OpenLabTools/OpenLabTools/Actuators/Linear Translation Stage Tutorial/Images/Step 12 - Bearings/12.4 Installing LM8UU.JPG

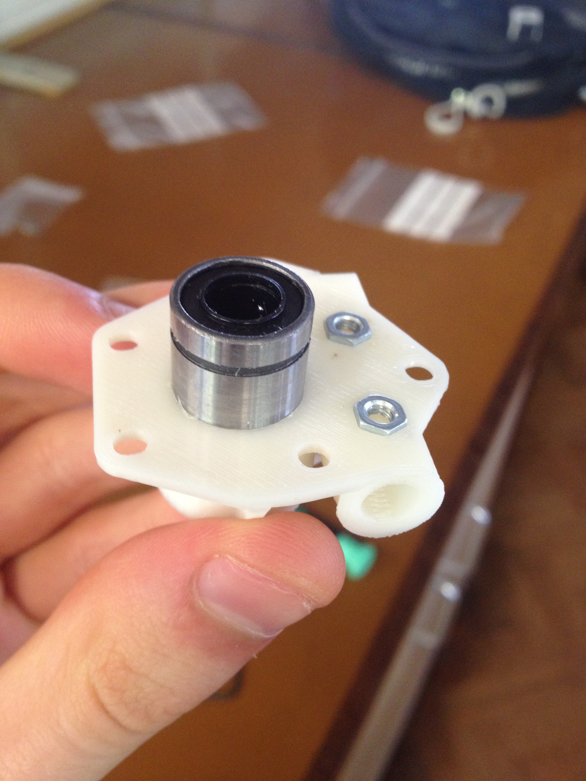
Actuators/Linear Translation Stage Tutorial/Images/Step 12 - Bearings/12.4 Installing LM8UU.JPG
