OpenLabTools/OpenLabTools/Actuators/Linear Translation Stage Tutorial/Images/Step 2 - Base/2.1.4 Stepper motor mounting plate.jpeg

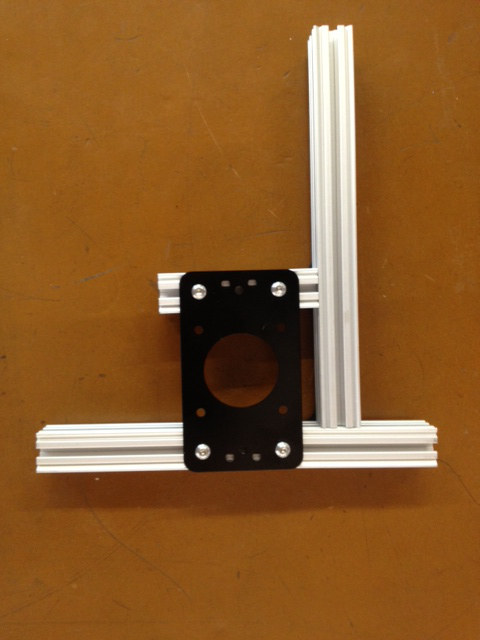
Actuators/Linear Translation Stage Tutorial/Images/Step 2 - Base/2.1.4 Stepper motor mounting plate.jpeg
