OpenLabTools/OpenLabTools/README.md

OpenLabTools
============

Main repository for the OpenLabTools project.
