OpenLabTools/OpenLabTools/Actuators/Linear Translation Stage Tutorial/Images/Step 1 - Printing the parts/Optics Clamp.JPG

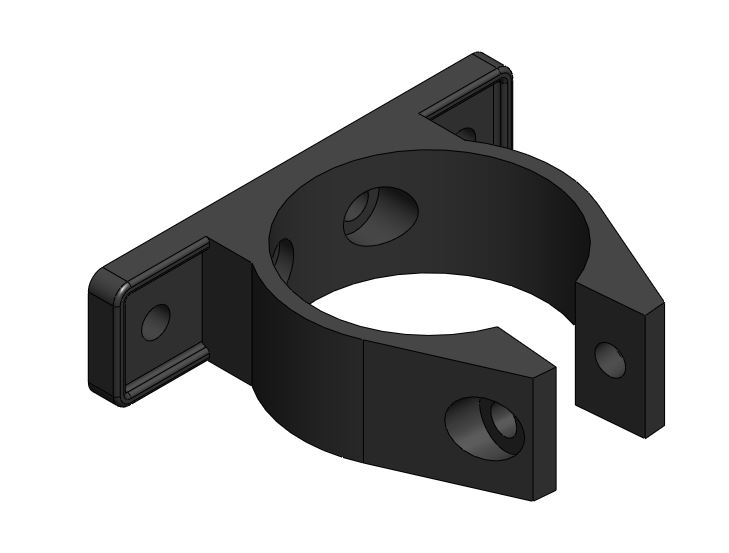
Actuators/Linear Translation Stage Tutorial/Images/Step 1 - Printing the parts/Optics Clamp.JPG
