OpenLabTools/OpenLabTools/Actuators/Linear Translation Stage Tutorial/Images/Step 7 - Optics Clamp/Optic Clamp Schematic.JPG

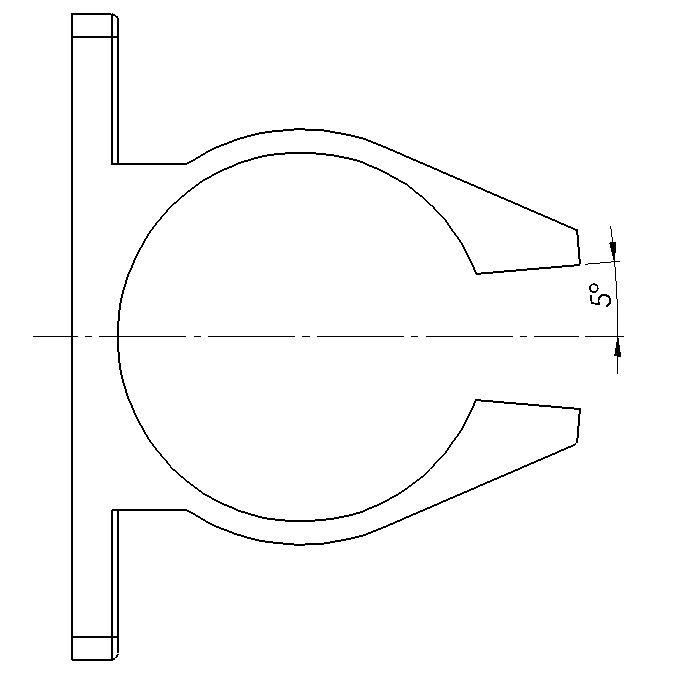
Actuators/Linear Translation Stage Tutorial/Images/Step 7 - Optics Clamp/Optic Clamp Schematic.JPG
