OpenLabTools/OpenLabTools/Actuators/Linear Translation Stage Tutorial/Images/Step 7 - Optics Clamp/Optics Clamp Top.JPG

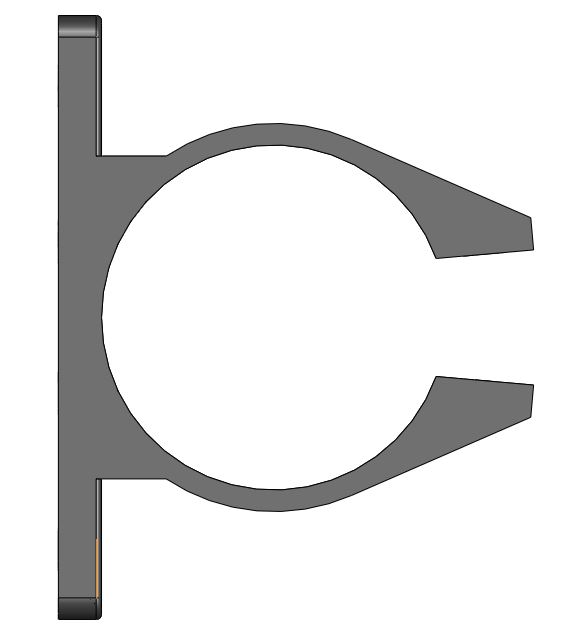
Actuators/Linear Translation Stage Tutorial/Images/Step 7 - Optics Clamp/Optics Clamp Top.JPG
