OpenLabTools/OpenLabTools/Actuators/Linear Translation Stage Tutorial/Images/Step 1 - Printing the parts/Bearing Mount Left - Bottom.JPG

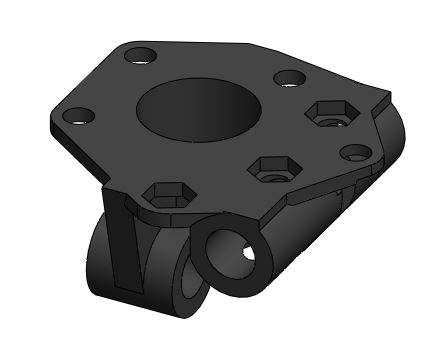
Actuators/Linear Translation Stage Tutorial/Images/Step 1 - Printing the parts/Bearing Mount Left - Bottom.JPG
