OpenLabTools/OpenLabTools/Actuators/Linear Translation Stage Tutorial/Images/Step 1 - Printing the parts/Bearing Mount Left - Top.JPG

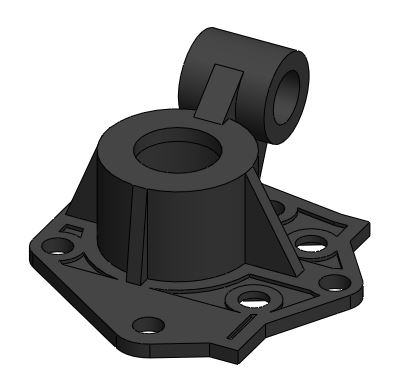
Actuators/Linear Translation Stage Tutorial/Images/Step 1 - Printing the parts/Bearing Mount Left - Top.JPG
