OpenLabTools/OpenLabTools/Actuators/Linear Translation Stage Tutorial/Images/Step 1 - Printing the parts/Bearing Mount Right - Bottom.JPG

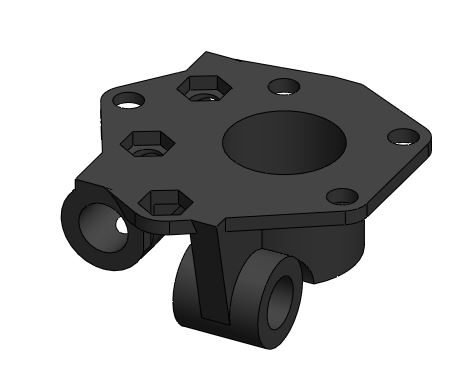
Actuators/Linear Translation Stage Tutorial/Images/Step 1 - Printing the parts/Bearing Mount Right - Bottom.JPG
