OpenLabTools/OpenLabTools/Actuators/Linear Translation Stage Tutorial/Images/Step 1 - Printing the parts/Endstop Mount.JPG

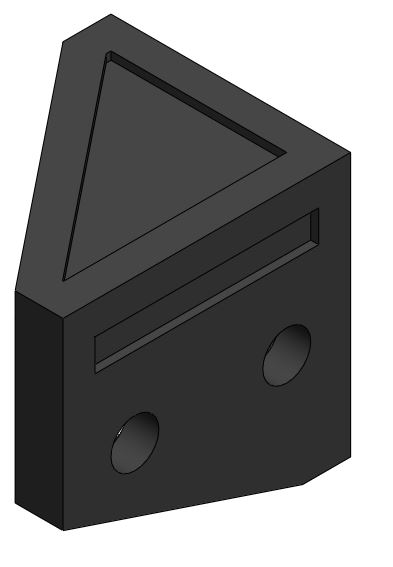
Actuators/Linear Translation Stage Tutorial/Images/Step 1 - Printing the parts/Endstop Mount.JPG
