OpenLabTools/OpenLabTools/Actuators/Linear Translation Stage Tutorial/Images/Step 1 - Printing the parts/Lead Nut Mount - Bottom.JPG

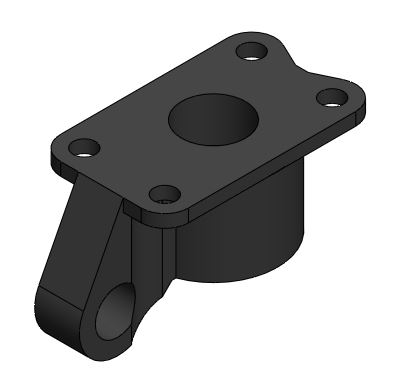
Actuators/Linear Translation Stage Tutorial/Images/Step 1 - Printing the parts/Lead Nut Mount - Bottom.JPG
