OpenLabTools/OpenLabTools/Actuators/Linear Translation Stage Tutorial/Images/Step 1 - Printing the parts/Lead Nut Mount - Top.JPG

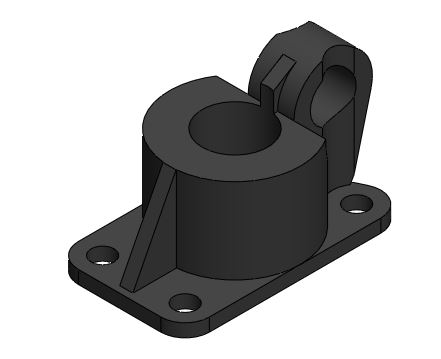
Actuators/Linear Translation Stage Tutorial/Images/Step 1 - Printing the parts/Lead Nut Mount - Top.JPG
