OpenLabTools/OpenLabTools/Actuators/Linear Translation Stage Tutorial/Images/Step 1 - Printing the parts/M3 Spacer.JPG

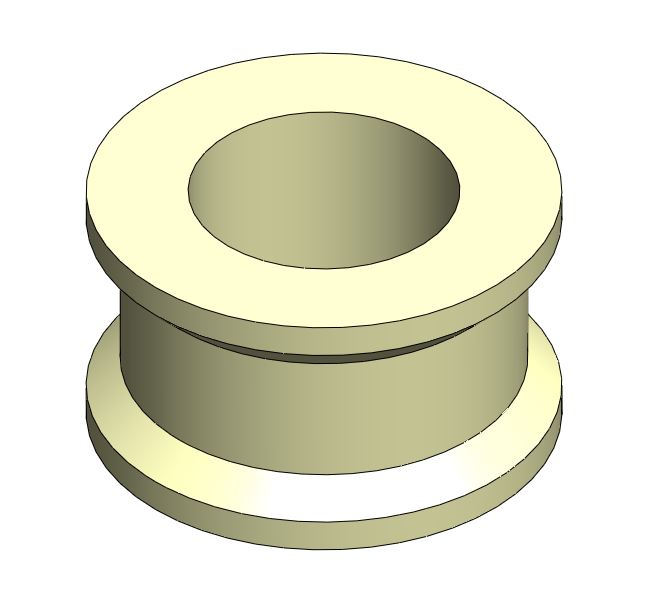
Actuators/Linear Translation Stage Tutorial/Images/Step 1 - Printing the parts/M3 Spacer.JPG
