OpenLabTools/OpenLabTools/Actuators/Linear Translation Stage Tutorial/Images/Step 1 - Printing the parts/Stage Endpiece.JPG

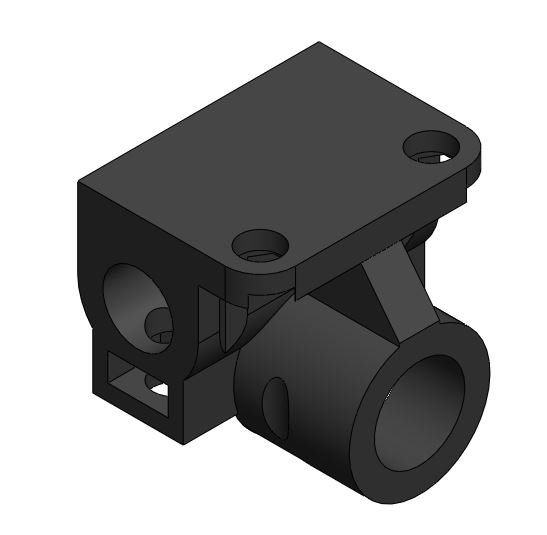
Actuators/Linear Translation Stage Tutorial/Images/Step 1 - Printing the parts/Stage Endpiece.JPG
