OpenLabTools/OpenLabTools/Actuators/Linear Translation Stage Tutorial/CAD Models/Bearing Mount Right Top.STL

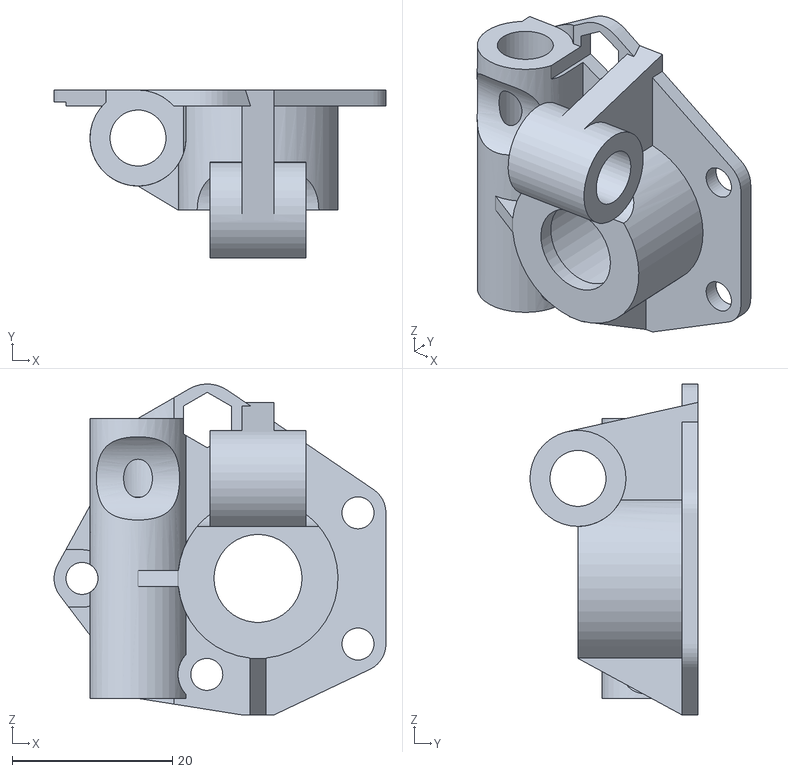
[picture p25: CAD file, 2013-08-30]
Actuators/Linear Translation Stage Tutorial/CAD Models/Bearing Mount Right Top.STL
41.5 x 21.0 x 41.4
