OpenLabTools/OpenLabTools/Actuators/Linear Translation Stage Tutorial/CAD Models/Front Stage Mount.STL

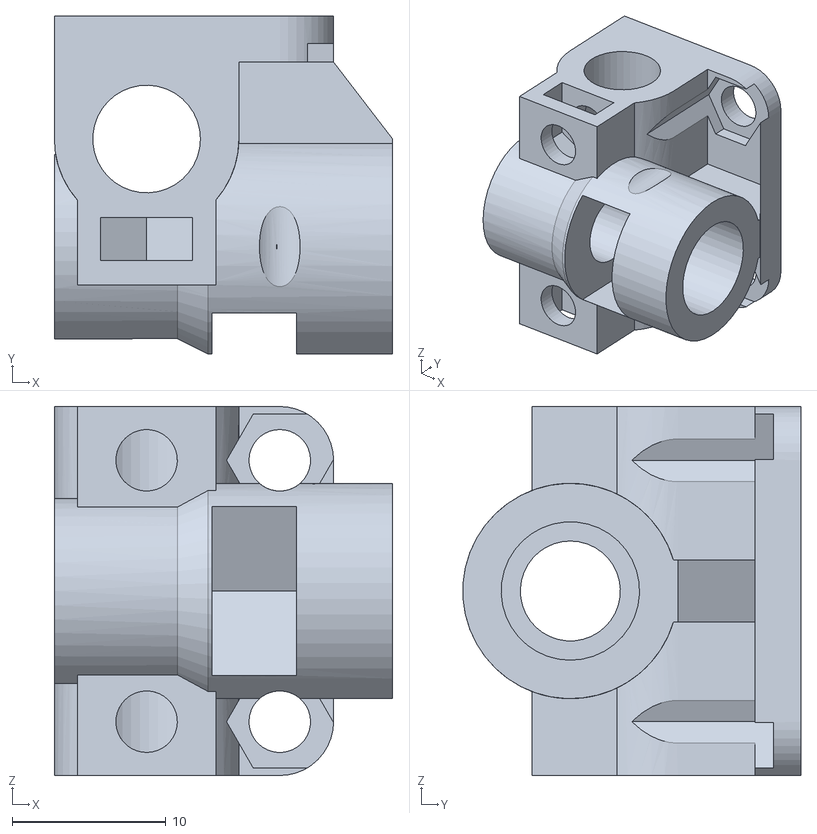
[picture p26: CAD file, 2013-08-30]
Actuators/Linear Translation Stage Tutorial/CAD Models/Front Stage Mount.STL
22.0 x 22.0 x 24.0
