OpenLabTools/OpenLabTools/Actuators/Linear Translation Stage Tutorial/CAD Models/Pi Camera Mount.STL

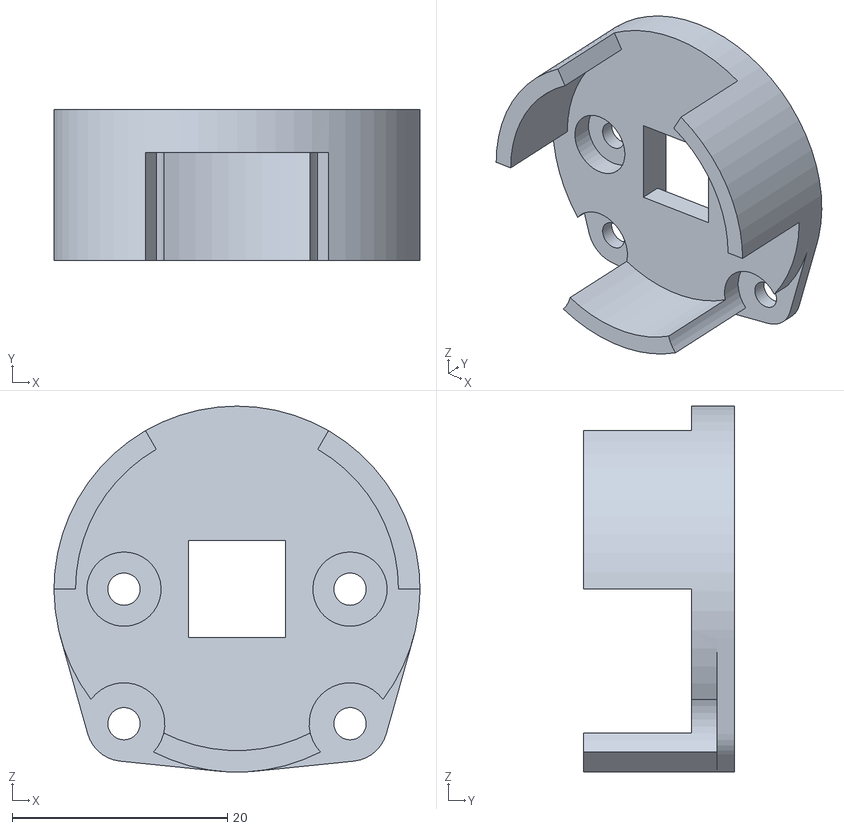
[picture p27: CAD file, 2013-08-30]
Actuators/Linear Translation Stage Tutorial/CAD Models/Pi Camera Mount.STL
34.0 x 14.0 x 34.0
