OpenLabTools/OpenLabTools/Actuators/Linear Translation Stage Tutorial/CAD Models/Lighting Mount.STL

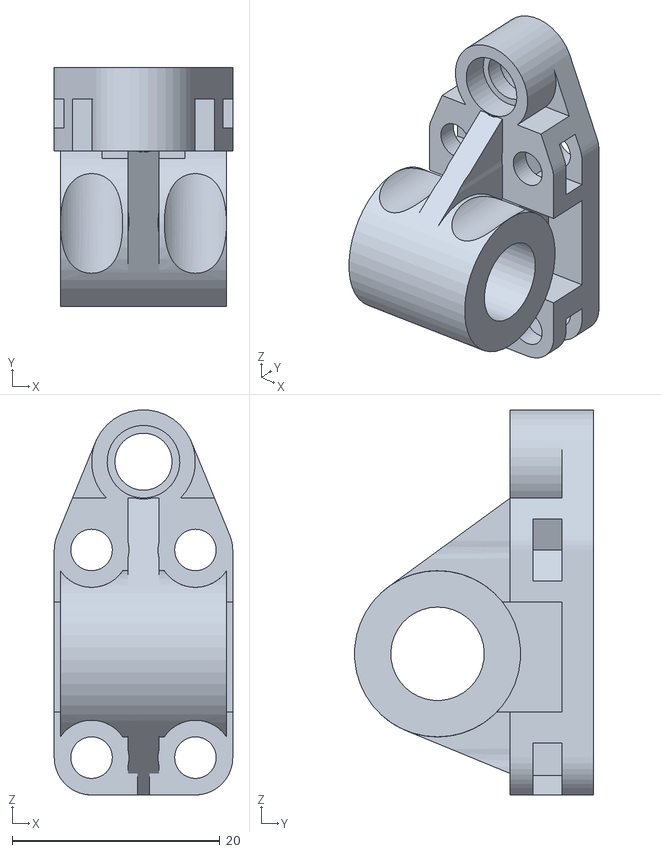
[picture p28: CAD file, 2013-08-30]
Actuators/Linear Translation Stage Tutorial/CAD Models/Lighting Mount.STL
17.2 x 23.0 x 37.1
