OpenLabTools/OpenLabTools/Actuators/Linear Translation Stage Tutorial/CAD Models/Bearing Mount Left Top.STL

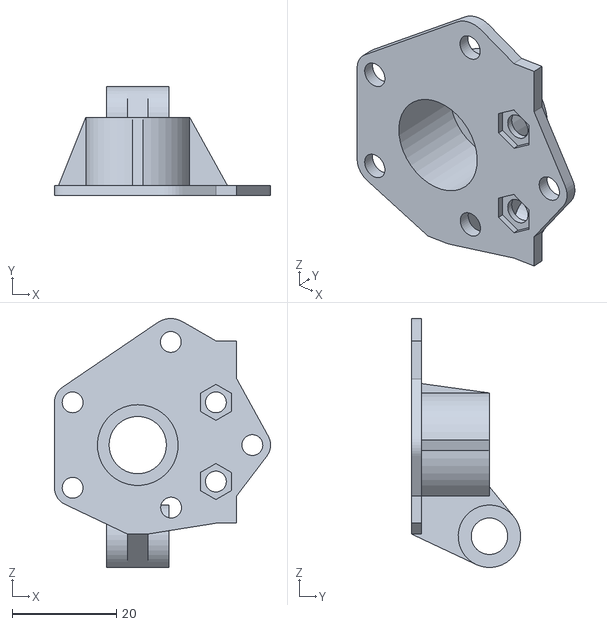
[picture p29: CAD file, 2013-08-30]
Actuators/Linear Translation Stage Tutorial/CAD Models/Bearing Mount Left Top.STL
41.5 x 21.0 x 47.8
