OpenLabTools/OpenLabTools/Actuators/Linear Translation Stage Tutorial/CAD Models/Endstop Mount.STL

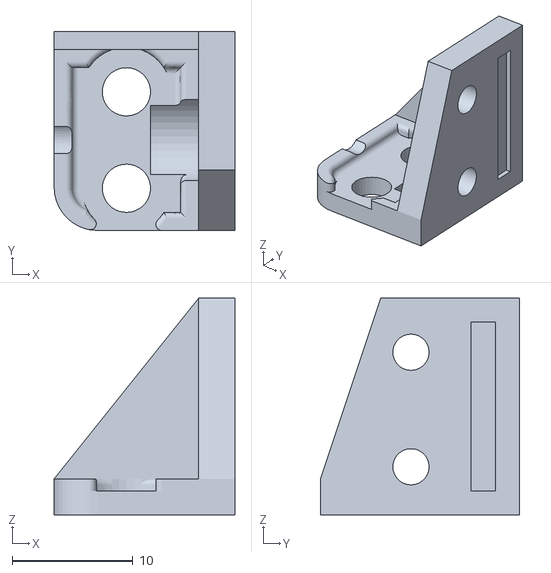
[picture p30: CAD file, 2013-08-30]
Actuators/Linear Translation Stage Tutorial/CAD Models/Endstop Mount.STL
15.0 x 16.5 x 18.0
