OpenLabTools/OpenLabTools/Actuators/Linear Translation Stage Tutorial/CAD Models/Stage Protector.STL

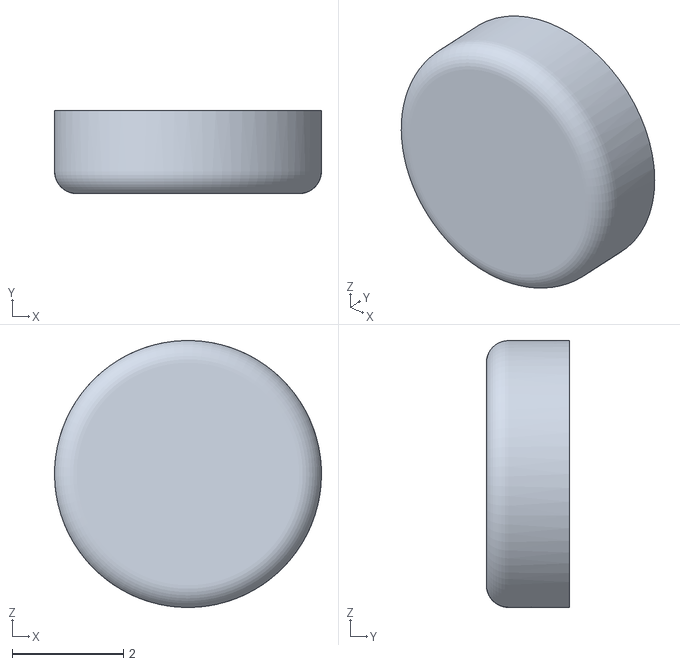
[picture p31: CAD file, 2013-08-30]
Actuators/Linear Translation Stage Tutorial/CAD Models/Stage Protector.STL
4.80 x 1.50 x 4.80
