OpenLabTools/OpenLabTools/Actuators/Linear Translation Stage Tutorial/CAD Models/M3 Spacer.STL

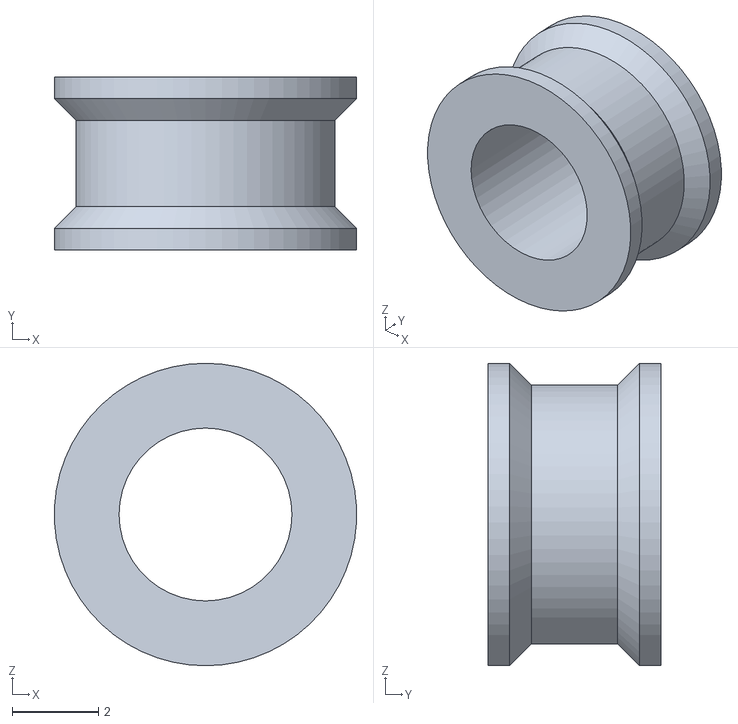
[picture p32: CAD file, 2013-08-30]
Actuators/Linear Translation Stage Tutorial/CAD Models/M3 Spacer.STL
6.99 x 4.00 x 7.00
