OpenLabTools/OpenLabTools/Actuators/Linear Translation Stage Tutorial/CAD Models/Optics Clamp.STL

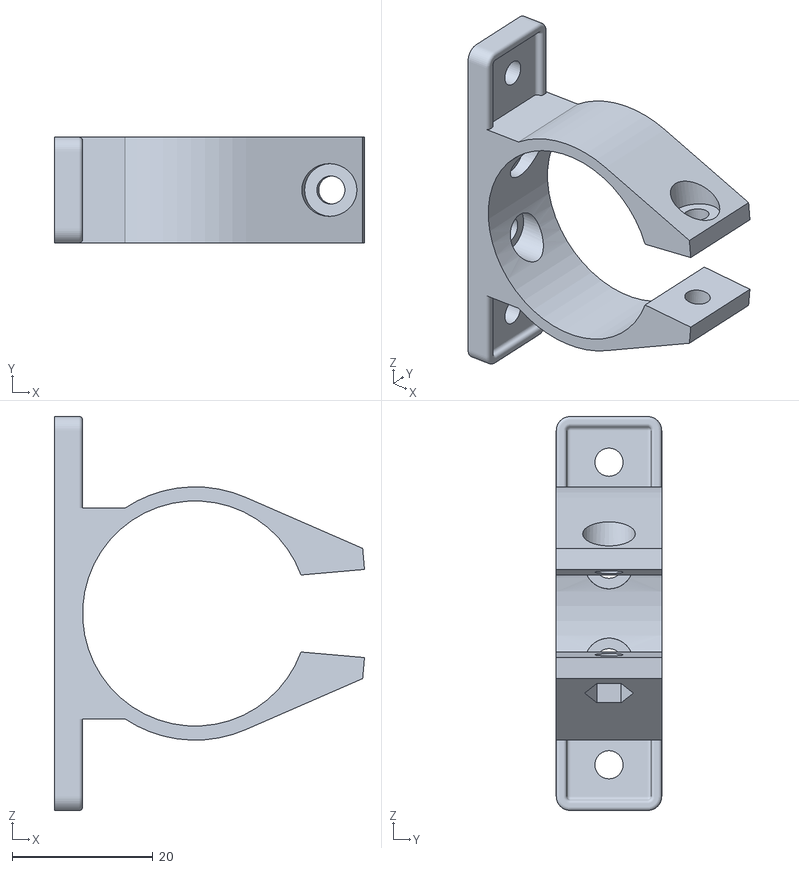
[picture p33: CAD file, 2013-08-30]
Actuators/Linear Translation Stage Tutorial/CAD Models/Optics Clamp.STL
44.1 x 15.0 x 56.0
