OpenLabTools/OpenLabTools/Actuators/Linear Translation Stage Tutorial/CAD Models/Thread Nut Mount Bottom.STL

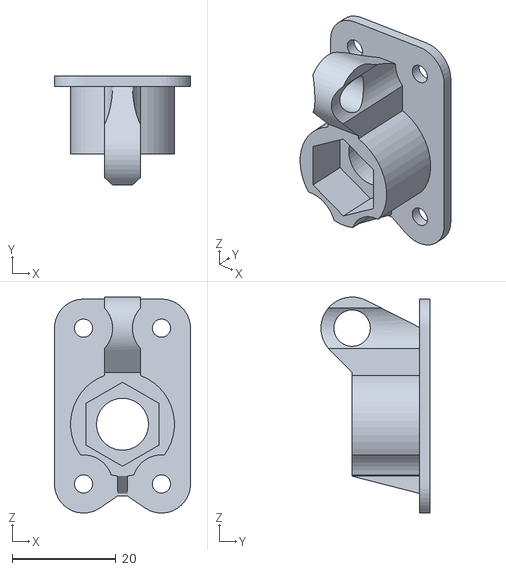
[picture p34: CAD file, 2013-08-30]
Actuators/Linear Translation Stage Tutorial/CAD Models/Thread Nut Mount Bottom.STL
26.2 x 21.0 x 41.6
