OpenLabTools/OpenLabTools/Actuators/Linear Translation Stage Tutorial/CAD Models/Thread Nut Mount Top.STL

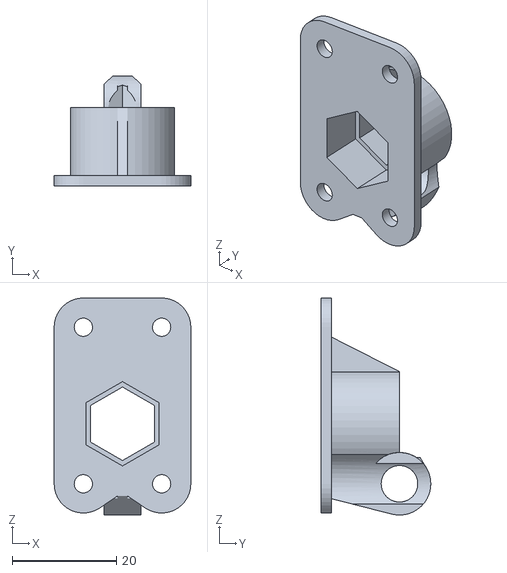
[picture p35: CAD file, 2013-08-30]
Actuators/Linear Translation Stage Tutorial/CAD Models/Thread Nut Mount Top.STL
26.2 x 21.0 x 41.6
