OpenLabTools/OpenLabTools/(list of files, cad)

Other CAD files:
Actuators/Linear Translation Stage Tutorial/CAD Models/Bearing Mount Left Bottom.STL
Actuators/Linear Translation Stage Tutorial/CAD Models/Bearing Mount Right Bottom.STL
