OpenLabTools/OpenLabTools/Actuators/Linear Translation Stage Tutorial/CAD Models/Stage Drawing.JPG

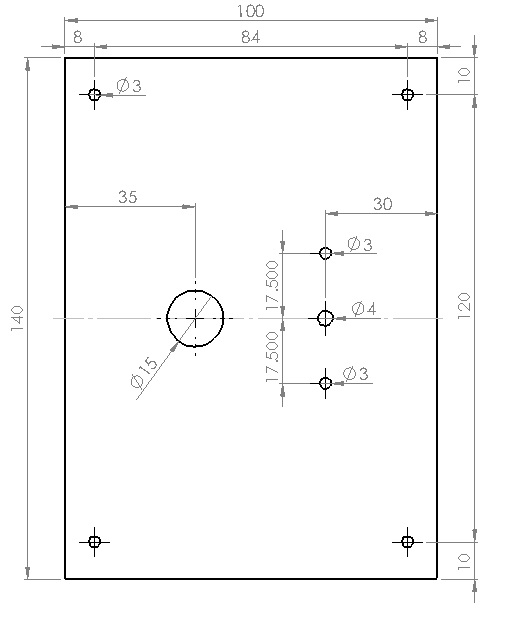
Actuators/Linear Translation Stage Tutorial/CAD Models/Stage Drawing.JPG
