OpenLabTools/OpenLabTools/Actuators/Linear Translation Stage Tutorial/Images/Step 2 - Base/2.1.1 T-Brackets with screws.jpeg

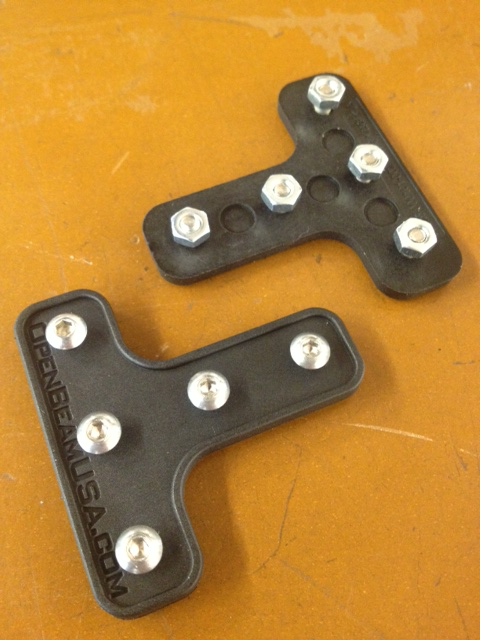
Actuators/Linear Translation Stage Tutorial/Images/Step 2 - Base/2.1.1 T-Brackets with screws.jpeg
