OpenLabTools/OpenLabTools/Actuators/Linear Translation Stage Tutorial/Images/Step 2 - Base/2.1.2 150mm and 60mm.jpeg

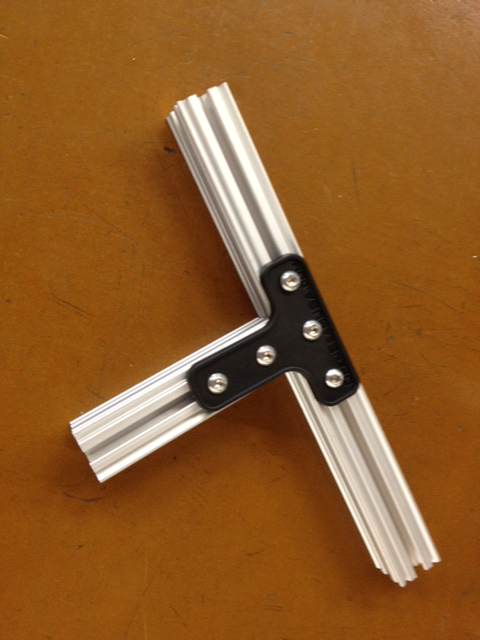
Actuators/Linear Translation Stage Tutorial/Images/Step 2 - Base/2.1.2 150mm and 60mm.jpeg
