OpenLabTools/OpenLabTools/Actuators/Linear Translation Stage Tutorial/Images/Step 2 - Base/2.1.3 Half of base.jpeg

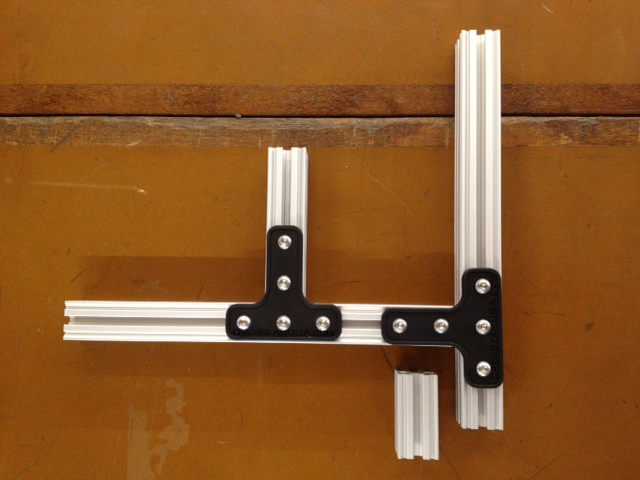
Actuators/Linear Translation Stage Tutorial/Images/Step 2 - Base/2.1.3 Half of base.jpeg
