OpenLabTools/OpenLabTools/Actuators/Linear Translation Stage Tutorial/Images/Step 2 - Base/2.1.5 Base symmetric.jpeg

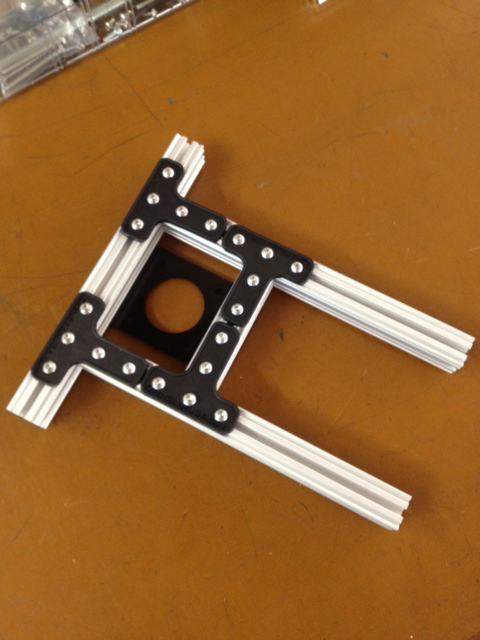
Actuators/Linear Translation Stage Tutorial/Images/Step 2 - Base/2.1.5 Base symmetric.jpeg
