OpenLabTools/OpenLabTools/Actuators/Linear Translation Stage Tutorial/Images/Step 2 - Base/Base 2.JPG

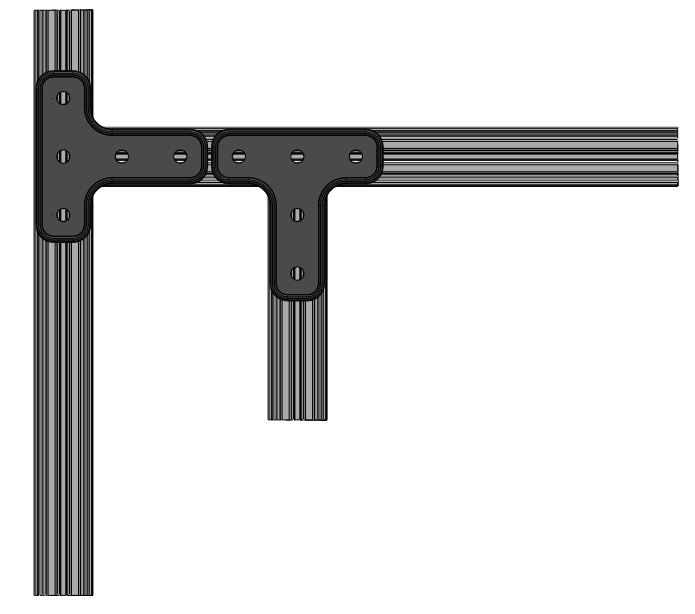
Actuators/Linear Translation Stage Tutorial/Images/Step 2 - Base/Base 2.JPG
