OpenLabTools/OpenLabTools/Actuators/Linear Translation Stage Tutorial/Images/Step 2 - Base/OpenBeams for Base.JPG

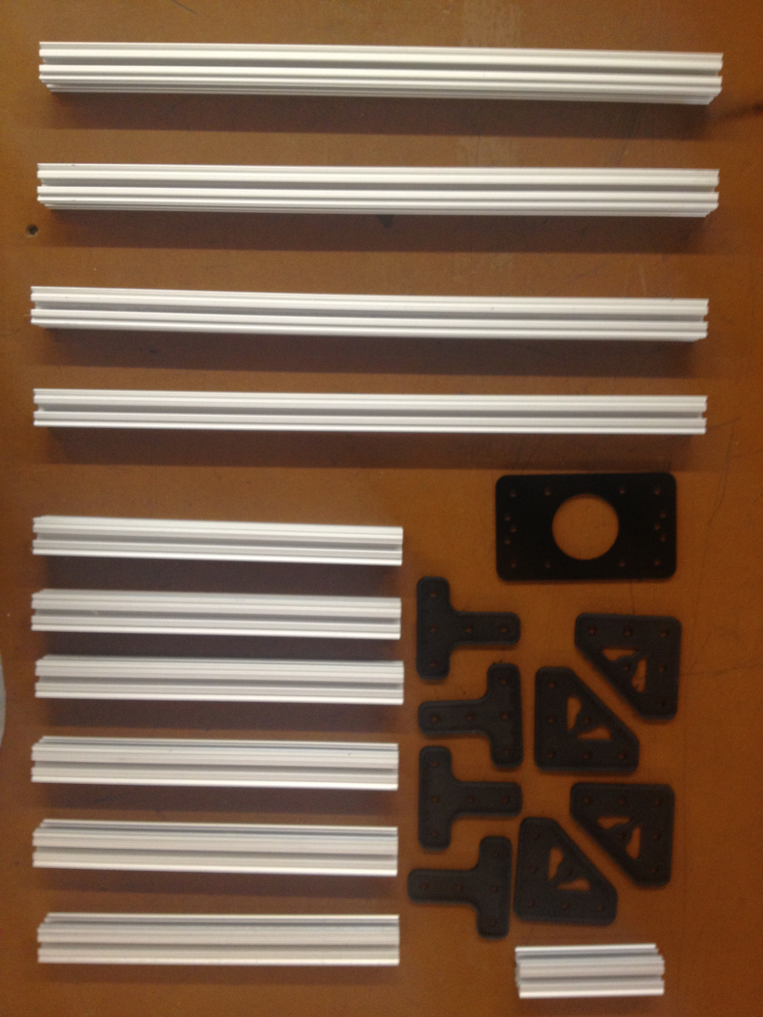
Actuators/Linear Translation Stage Tutorial/Images/Step 2 - Base/OpenBeams for Base.JPG
