OpenLabTools/OpenLabTools/Actuators/Linear Translation Stage Tutorial/Images/Step 6 - Endstops/Endstop Interior.JPG

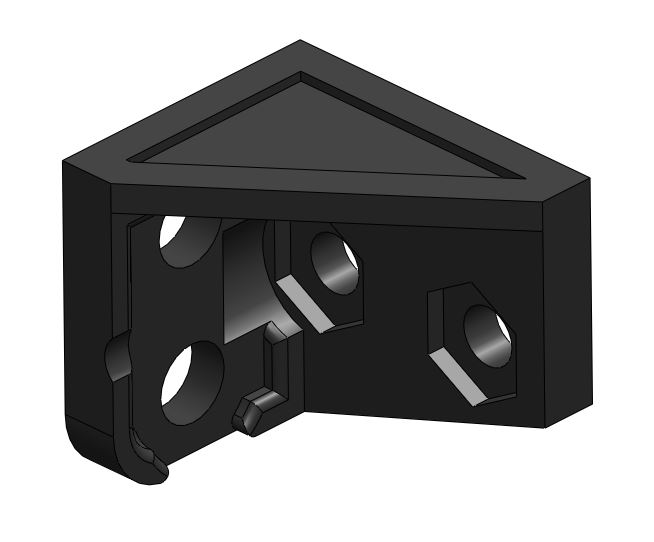
Actuators/Linear Translation Stage Tutorial/Images/Step 6 - Endstops/Endstop Interior.JPG
