OpenLabTools/OpenLabTools/Actuators/Linear Translation Stage Tutorial/Images/Step 6 - Endstops/Endstops Mounted.JPG

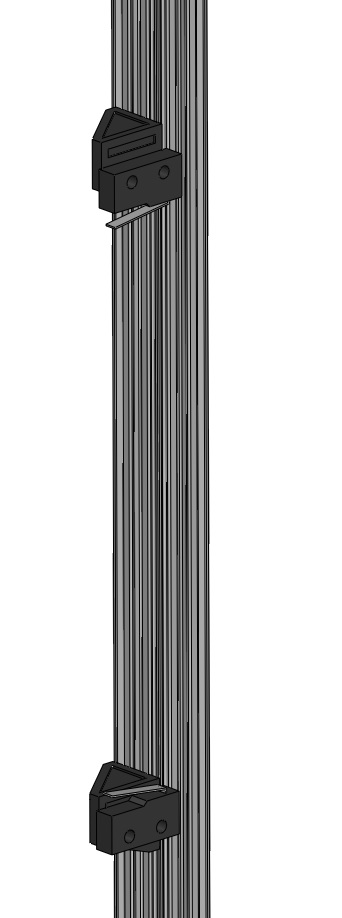
Actuators/Linear Translation Stage Tutorial/Images/Step 6 - Endstops/Endstops Mounted.JPG
