OpenLabTools/OpenLabTools/Actuators/Linear Translation Stage Tutorial/Images/Step 7 - Optics Clamp/Top Frame.JPG

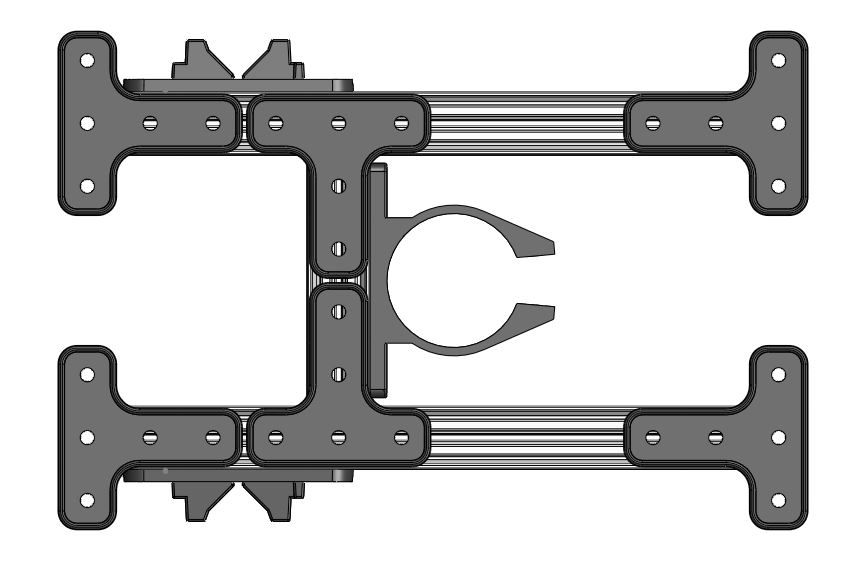
Actuators/Linear Translation Stage Tutorial/Images/Step 7 - Optics Clamp/Top Frame.JPG
