OpenLabTools/OpenLabTools/Actuators/Linear Translation Stage Tutorial/Images/Step 8 - Upper Shaft Clamps/8.1 Shaft Clamp.JPG

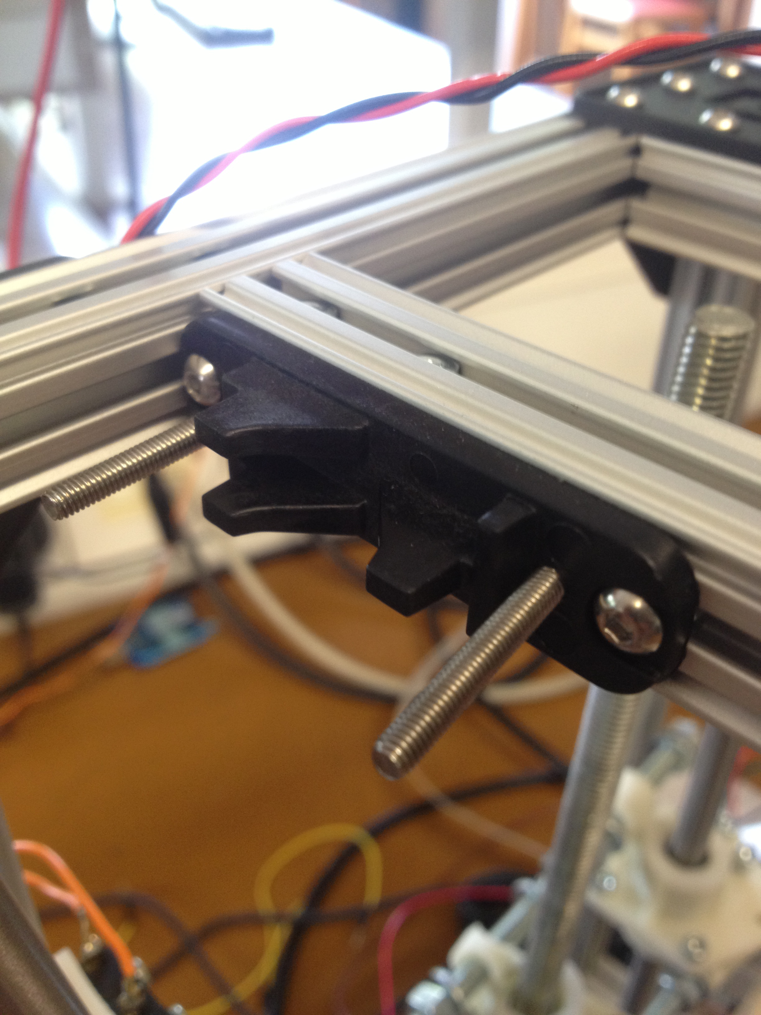
Actuators/Linear Translation Stage Tutorial/Images/Step 8 - Upper Shaft Clamps/8.1 Shaft Clamp.JPG
