OpenLabTools/OpenLabTools/Actuators/Linear Translation Stage Tutorial/Images/Step 10 - Lead Nut/10.2 Leadnut Assembly.JPG

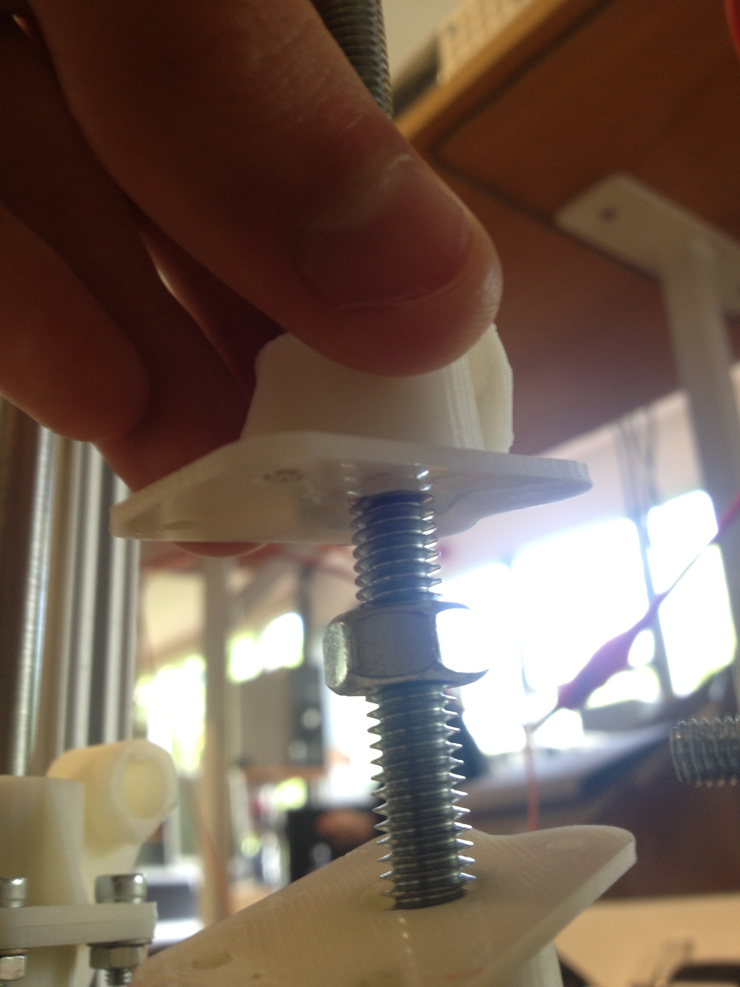
Actuators/Linear Translation Stage Tutorial/Images/Step 10 - Lead Nut/10.2 Leadnut Assembly.JPG
