OpenLabTools/OpenLabTools/Actuators/Linear Translation Stage Tutorial/Images/Step 10 - Lead Nut/Thread Nut Hex Hole.JPG

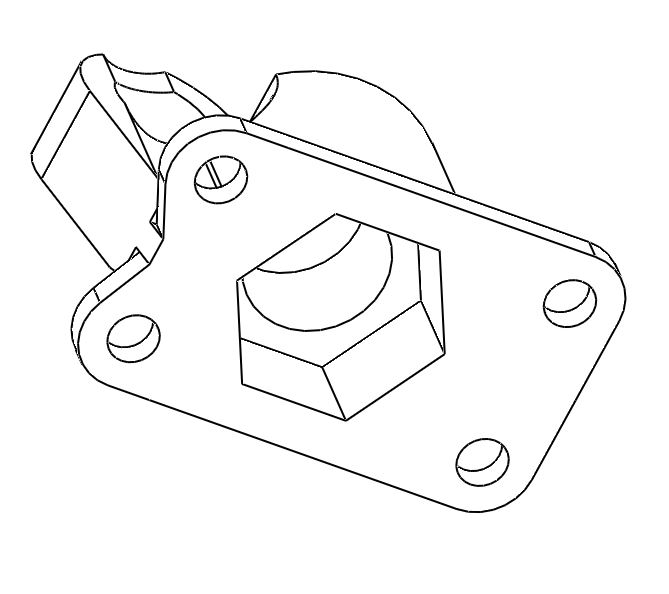
Actuators/Linear Translation Stage Tutorial/Images/Step 10 - Lead Nut/Thread Nut Hex Hole.JPG
