OpenLabTools/OpenLabTools/Actuators/Linear Translation Stage Tutorial/Images/Step 12 - Bearings/12.2 Bearing Mount Assembled.JPG

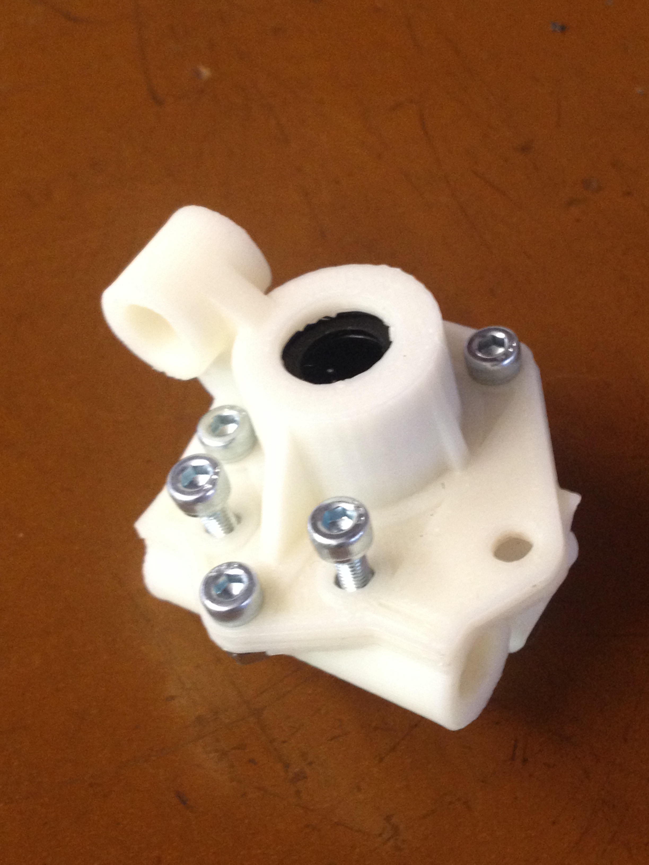
Actuators/Linear Translation Stage Tutorial/Images/Step 12 - Bearings/12.2 Bearing Mount Assembled.JPG
