OpenLabTools/OpenLabTools/Actuators/Linear Translation Stage Tutorial/Images/Step 12 - Bearings/12.3 Bearing Mount Disassembled.JPG

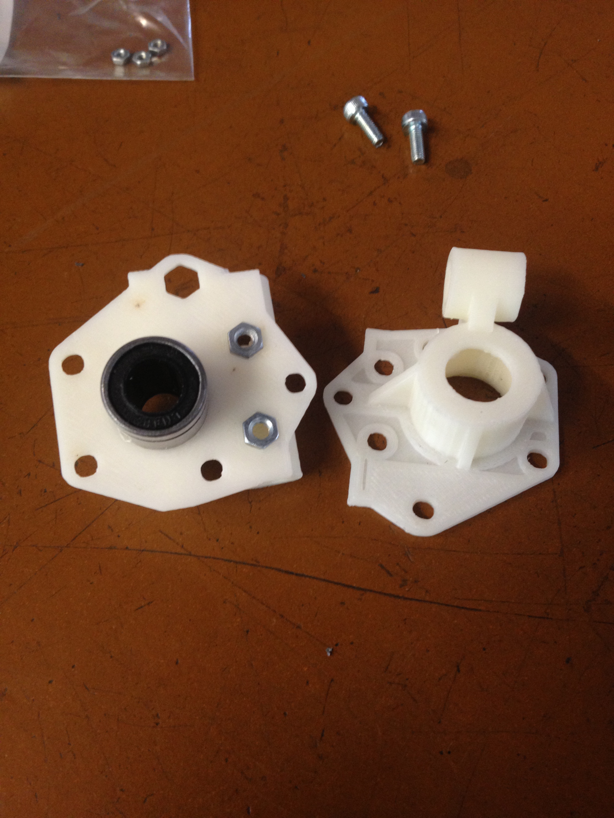
Actuators/Linear Translation Stage Tutorial/Images/Step 12 - Bearings/12.3 Bearing Mount Disassembled.JPG
