OpenLabTools/OpenLabTools/Actuators/Linear Translation Stage Tutorial/Images/Step 13 - Stage Frame/13.2 Threading Crossbeam.JPG

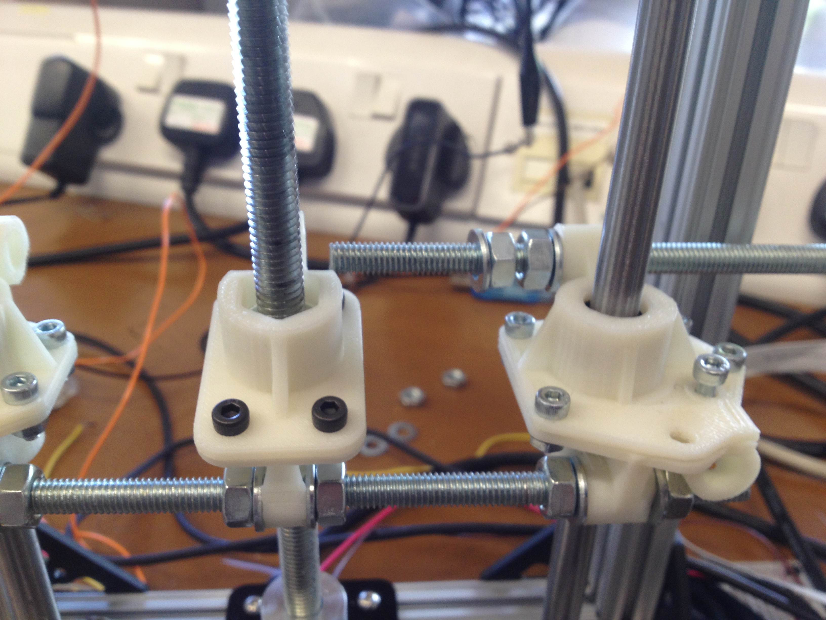
Actuators/Linear Translation Stage Tutorial/Images/Step 13 - Stage Frame/13.2 Threading Crossbeam.JPG
