OpenLabTools/OpenLabTools/Actuators/Linear Translation Stage Tutorial/Images/Step 13 - Stage Frame/13.3 Threading Crossbeam Part 3.JPG

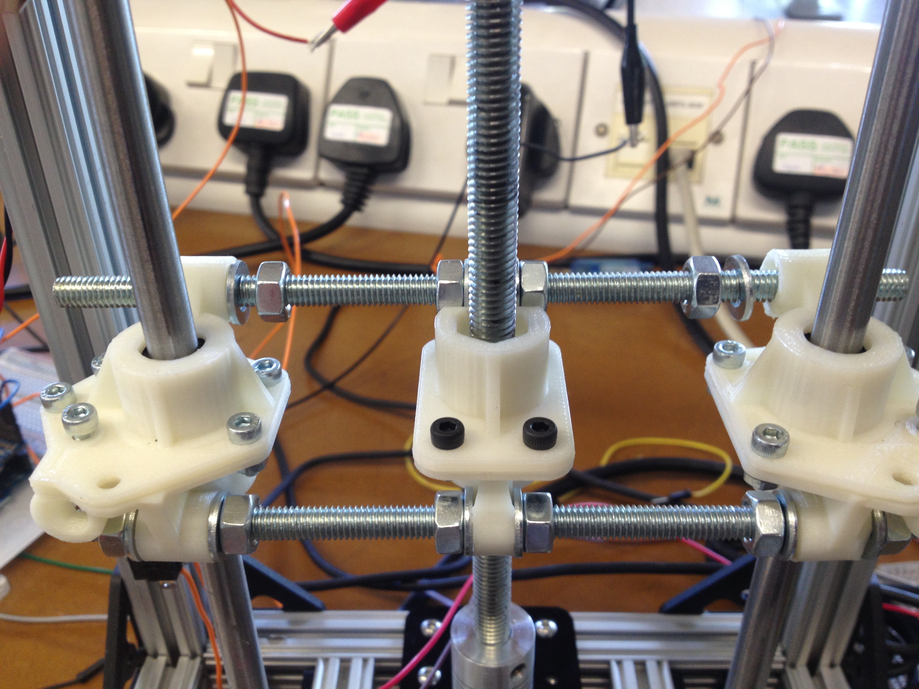
Actuators/Linear Translation Stage Tutorial/Images/Step 13 - Stage Frame/13.3 Threading Crossbeam Part 3.JPG
