OpenLabTools/OpenLabTools/Actuators/Linear Translation Stage Tutorial/Images/Step 14 - Stage End Pieces/IMG_1395.JPG

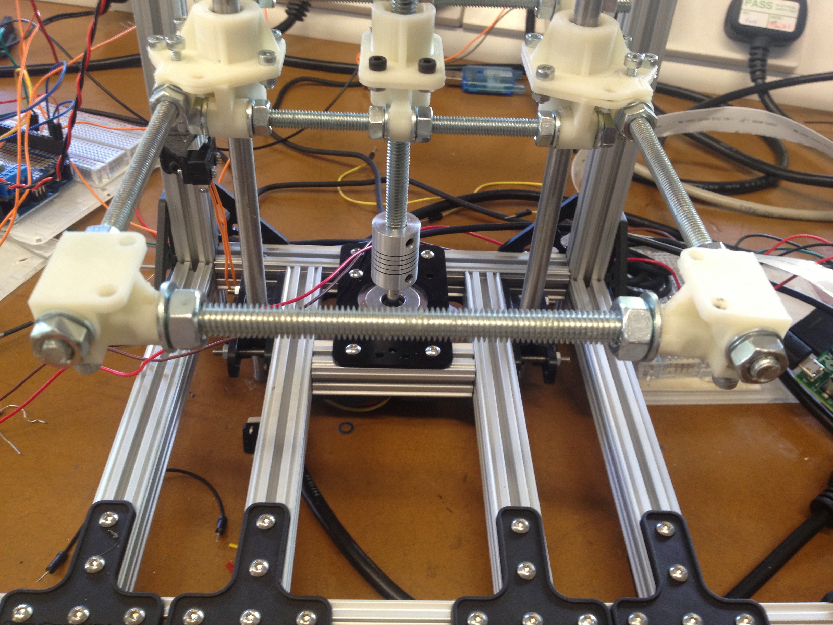
Actuators/Linear Translation Stage Tutorial/Images/Step 14 - Stage End Pieces/IMG_1395.JPG
