OpenLabTools/OpenLabTools/Actuators/Linear Translation Stage Tutorial/Images/Step 14 - Stage End Pieces/IMG_1396.JPG

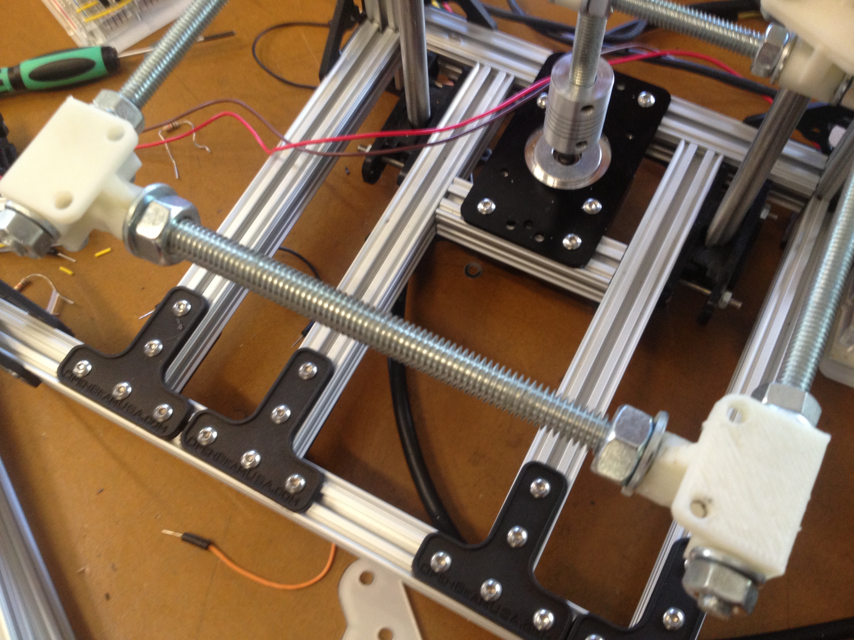
Actuators/Linear Translation Stage Tutorial/Images/Step 14 - Stage End Pieces/IMG_1396.JPG
