OpenLabTools/OpenLabTools/Actuators/Linear Translation Stage Tutorial/Images/Step 15 - Mounting Stage/IMG_1398.JPG

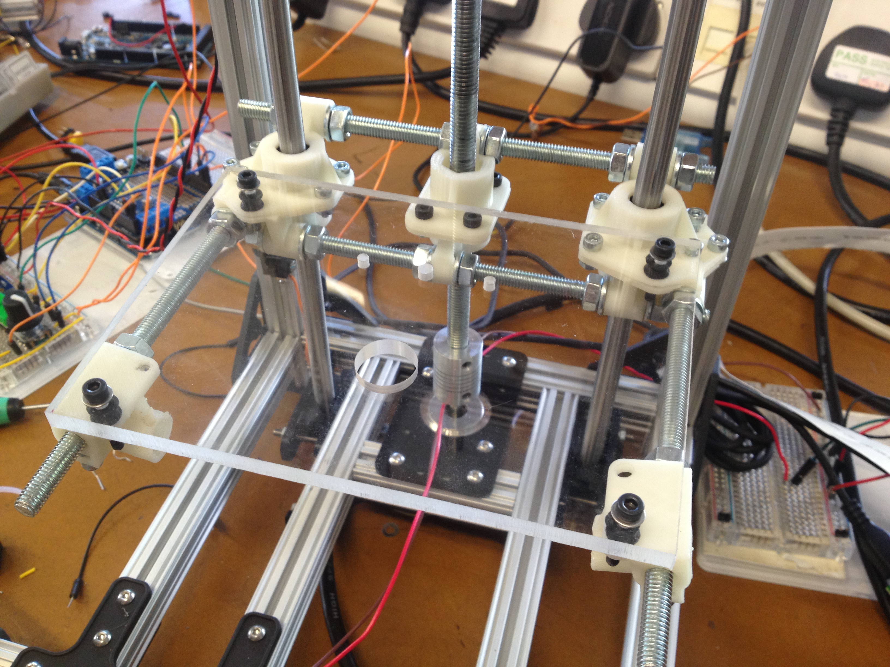
Actuators/Linear Translation Stage Tutorial/Images/Step 15 - Mounting Stage/IMG_1398.JPG
