OpenLabTools/OpenLabTools/Actuators/Linear Translation Stage Tutorial/Images/Step 16 - Connecting the stepper/Motor Wiring.jpeg

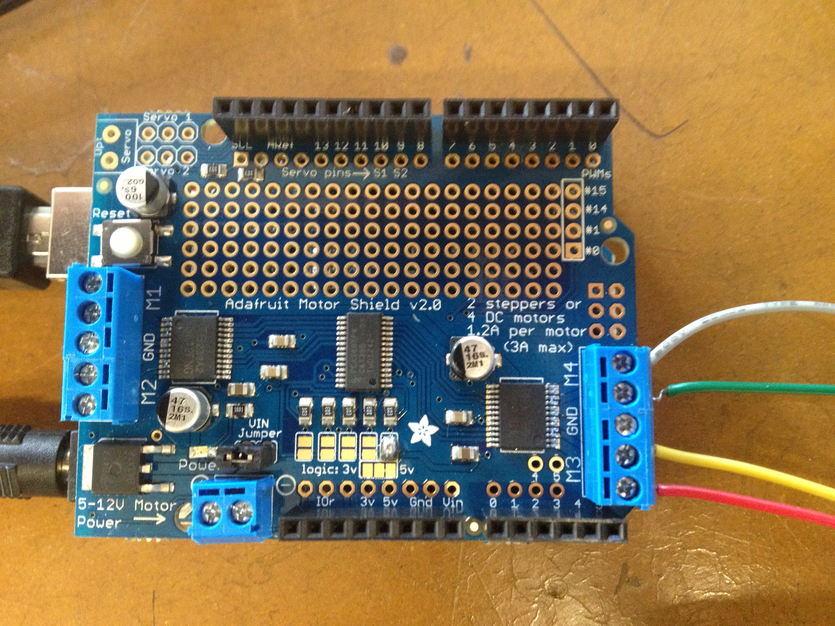
Actuators/Linear Translation Stage Tutorial/Images/Step 16 - Connecting the stepper/Motor Wiring.jpeg
