OpenLabTools/OpenLabTools/Actuators/Linear Translation Stage Tutorial/Images/Step 17 - Switches and Input/17.1 Buttons.JPG

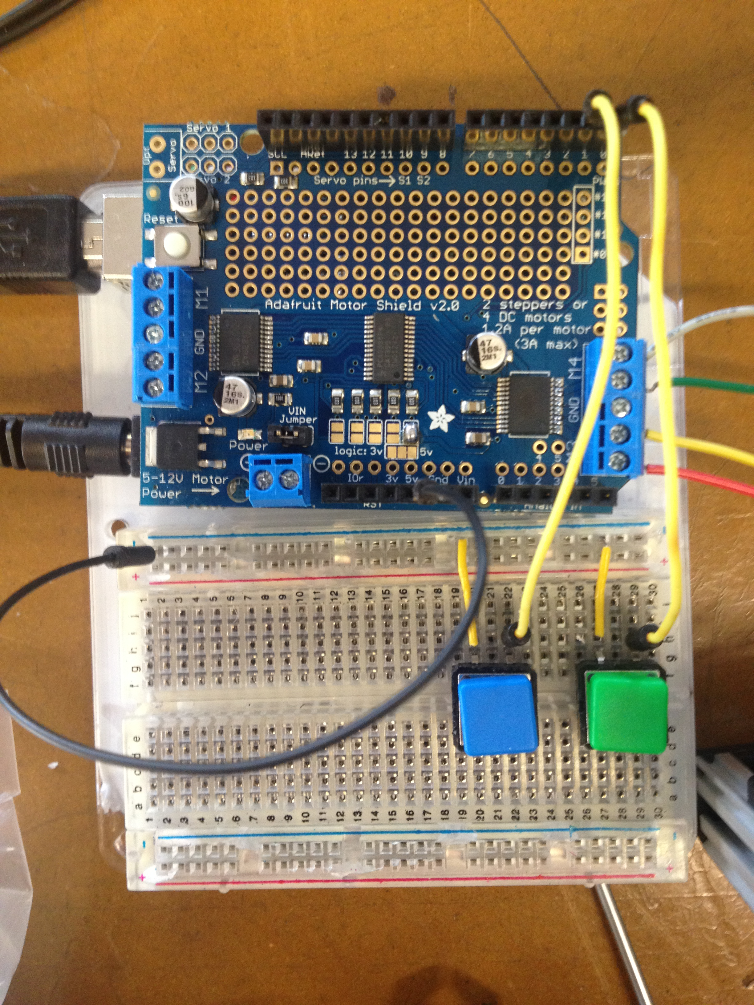
Actuators/Linear Translation Stage Tutorial/Images/Step 17 - Switches and Input/17.1 Buttons.JPG
