OpenLabTools/OpenLabTools/Actuators/Linear Translation Stage Tutorial/Images/Step 17 - Switches and Input/17.2 Microswitch Wiring.JPG

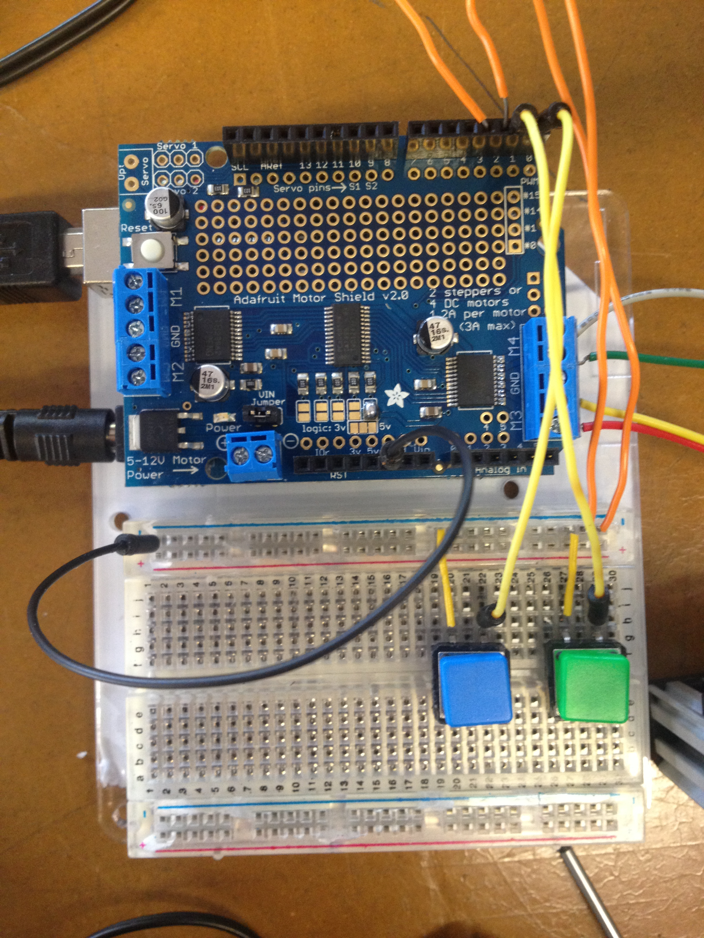
Actuators/Linear Translation Stage Tutorial/Images/Step 17 - Switches and Input/17.2 Microswitch Wiring.JPG
