OpenLabTools/OpenLabTools/Actuators/Linear Translation Stage Tutorial/Images/Step 18 - Software/Arduino IDE.JPG

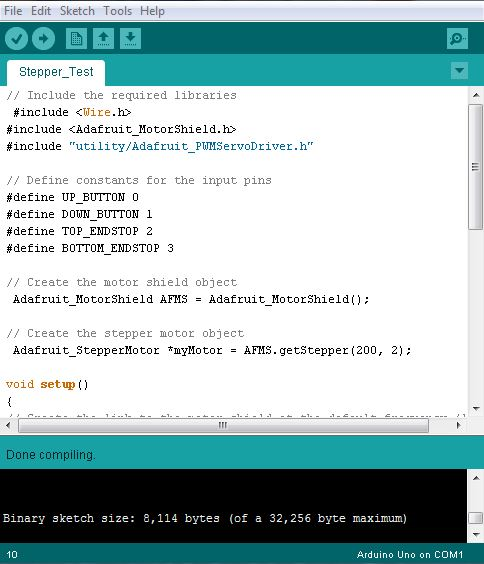
Actuators/Linear Translation Stage Tutorial/Images/Step 18 - Software/Arduino IDE.JPG
