OpenLabTools/OpenLabTools/(commit log)

2013-07-04 Arduino Code for listening to Pi
    This code for the Arduino reads a byte over i2c from the Pi and then
    either toggles an LED or moves a servo.
2013-08-30 Structuring folders and adding resources
    Restructured the repository to match website. Adding images and code for
    stage tutorial
2013-08-30 Adding CAD
    [Bearing Mount Left Bottom.STL, Bearing Mount Left Top.STL, Bearing Mount Right Bottom.STL, Bearing Mount Right Top.STL, Endstop Mount.STL, Front Stage Mount.STL, Lighting Mount.STL, M3 Spacer.STL]
2013-08-30 Adding Stage Tutorial
